telzo2000/cool847/img/img00004.jpg

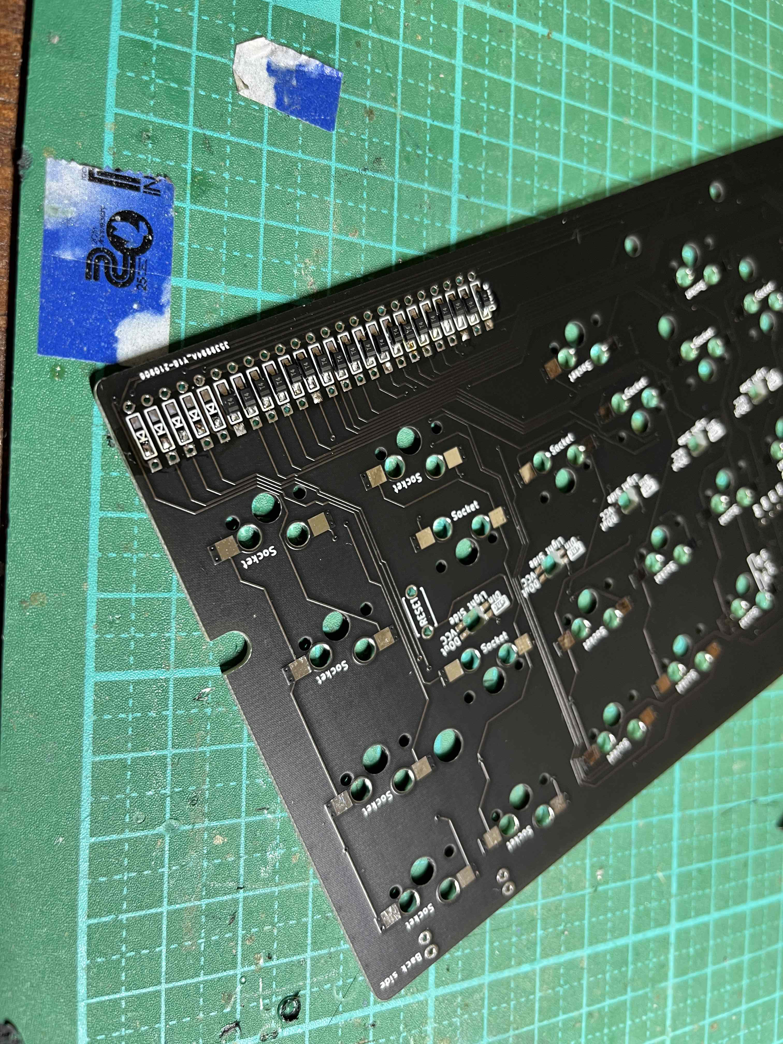
[picture p12: img/img00004.jpg]
img/img00004.jpg
